he1ias/Holographic-Clock-Display/BOM.csv

Item | Qty | Supplier | Cost/item | Total Cost | link
XIAO RP2040 ESP32 | 1 | seeedstudio | $3.90 | $3.90 | https://www.seeedstudio.com/XIAO-RP2040-v1-0-p-5026.html
Display | 4 | LCSC | $2.22 | $8.88 | https://www.lcsc.com/product-detail/C7471924.html
Button | 10 | LCSC | $0.06 | $0.60 | https://www.lcsc.com/product-detail/C49393619.html
Thumbwheel Potentiometer | 1 | LCSC | $1.08 | $1.08 | https://www.lcsc.com/product-detail/C470643.html
Male pin headers | 5 | LCSC | $0.16 | $0.80 | https://www.lcsc.com/product-detail/C2337.html
JLCPCB | 1 | JLC | $4.00 | $4.00 | https://jlcpcb.com/
JLC3DP | 1 | JLC | $6.50 | $6.50 | https://www.jlc3dp.com
Reflective material (eg. acrylic sheet) (already owned) | 1 | Amazon | $0.01 | $0.01 | https://www.amazon.com.au/Pack-Clear-Acrylic-Sheets-Transparent/dp/B0H6PXC3K6
M2 Screws (already owned) | 4 | AliExpress | $0.01 | $0.04 | https://www.aliexpress.com/item/4000056753202.html
Estimated total shipping | 1 |  |  | $13.00
