he1ias/Holographic-Clock-Display/3D Outputs/Casing STEP Outputs/Hologram (Fixed) - Walls.step

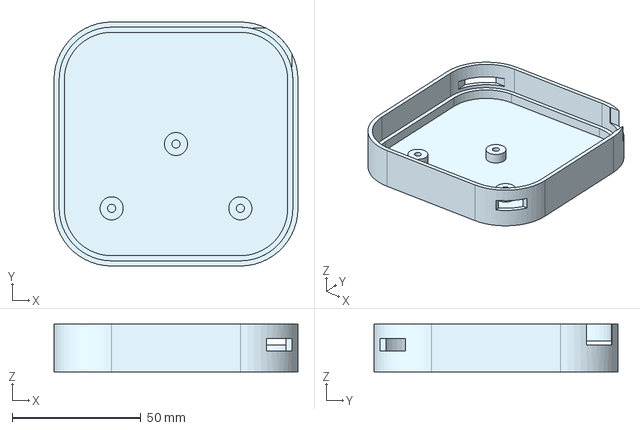
[picture p6: CAD file, 2026-10-31]
3D Outputs/Casing STEP Outputs/Hologram (Fixed) - Walls.step
94.8 x 94.8 x 18.5 mm
