he1ias/Holographic-Clock-Display/3D Outputs/Hologram_PCB.step

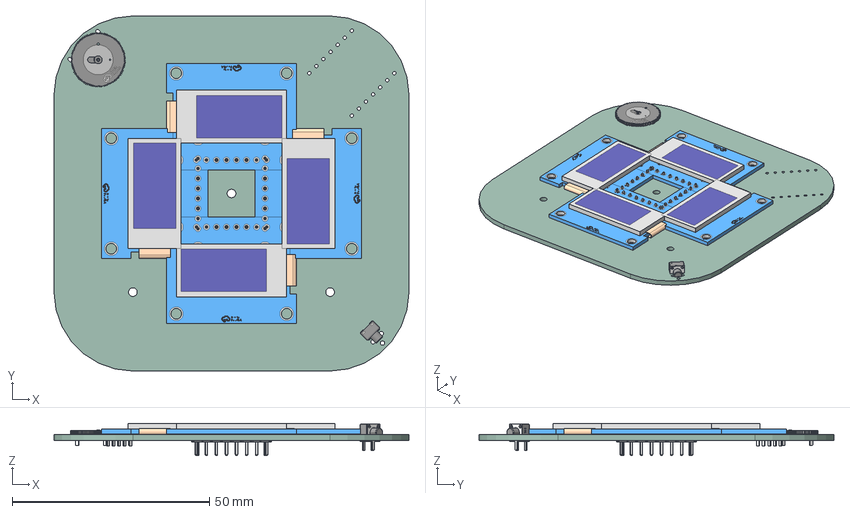
[picture p7: CAD file, 2026-10-31]
3D Outputs/Hologram_PCB.step
90.0 x 90.0 x 8.20 mm
SW-TH_3P-L4.5-W5.0-P3.00-LS1.9
LCD-TH_HS96S01A x 4
RES-TH_RK10J12E0A0A
Hologram_PCB
