he1ias/Holographic-Clock-Display/3D Outputs/Casing STEP Outputs/Hologram (Fixed) - Roof.step

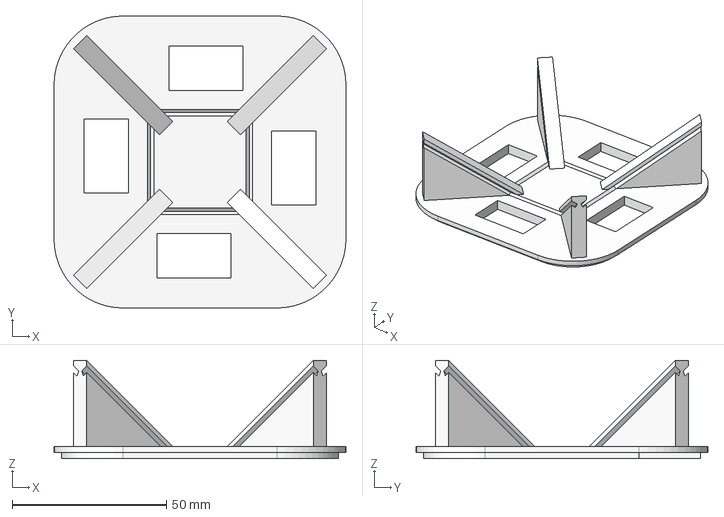
[picture p8: CAD file, 2026-10-31]
3D Outputs/Casing STEP Outputs/Hologram (Fixed) - Roof.step
94.8 x 94.8 x 31.9 mm
