he1ias/Holographic-Clock-Display/(list of files, cad)

Other CAD files:
3D Outputs/Casing STL Outputs/Hologram (Fixed) - Roof.stl
3D Outputs/Casing STL Outputs/Hologram (Fixed) - Walls.stl
