he1ias/Holographic-Clock-Display/KiCad Files/Hologram.kicad_pcb

## KiCad design KiCad Files/Hologram.kicad_pcb (2026-10-31)

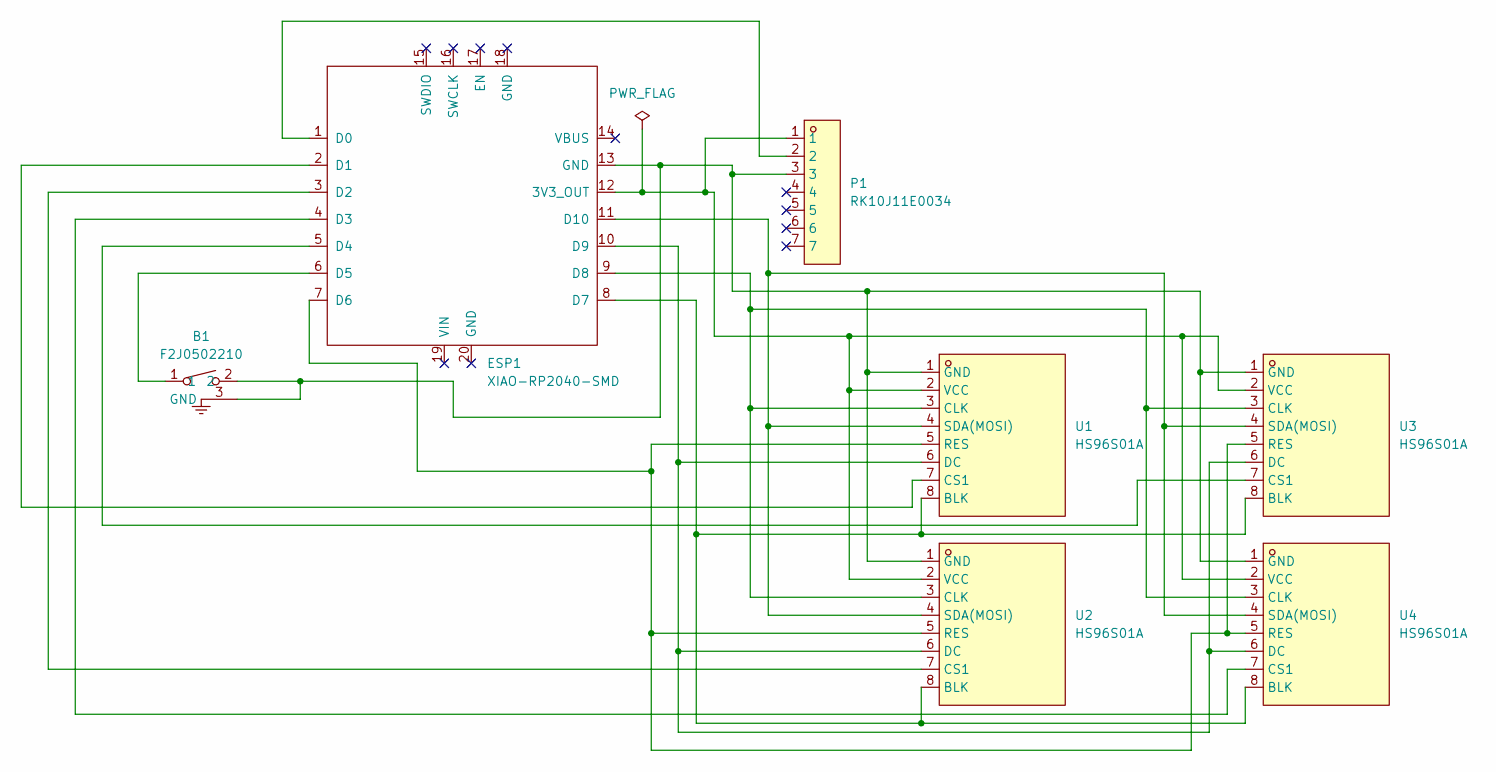
[picture p9: schematic Hologram.kicad_sch]

Parts:
B1: F2J0502210; SW-TH_3P-L4.5-W5.0-P3.00-LS1.9; MPN F2J0502210; LCSC Part C49393619
ESP1: XIAO-RP2040-SMD; XIAO-RP2040-DIP
P1: RK10J11E0034; RES-TH_RK10J12E0A0A; MPN RK10J11E0034; LCSC Part C470643
U1, U2, U3, U4: HS96S01A; LCD-TH_HS96S01A; MPN HS96S01A; LCSC Part C7471924

Connections:
unnamed: B1.2, B1.3 (GND), ESP1.13 (GND), P1.3, U1.1 (GND), U2.1 (GND), U3.1 (GND), U4.1 (GND)
unnamed: ESP1.12 (3V3_OUT), P1.1, U1.2 (VCC), U2.2 (VCC), U3.2 (VCC), U4.2 (VCC)
unnamed: ESP1.1 (D0), P1.2
unnamed: ESP1.2 (D1), U1.7 (CS1)
unnamed: ESP1.3 (D2), U2.7 (CS1)
unnamed: ESP1.4 (D3), U4.7 (CS1)
unnamed: ESP1.5 (D4), U3.7 (CS1)
unnamed: B1.1, ESP1.6 (D5)
unnamed: ESP1.7 (D6), U1.5 (RES), U2.5 (RES), U3.5 (RES), U4.5 (RES)
unnamed: ESP1.8 (D7), U1.8 (BLK), U2.8 (BLK), U3.8 (BLK), U4.8 (BLK)
unnamed: ESP1.9 (D8), U1.3 (CLK), U2.3 (CLK), U3.3 (CLK), U4.3 (CLK)
unnamed: ESP1.10 (D9), U1.6 (DC), U2.6 (DC), U3.6 (DC), U4.6 (DC)
unnamed: ESP1.11 (D10), U1.4 (SDA(MOSI)), U2.4 (SDA(MOSI)), U3.4 (SDA(MOSI)), U4.4 (SDA(MOSI))

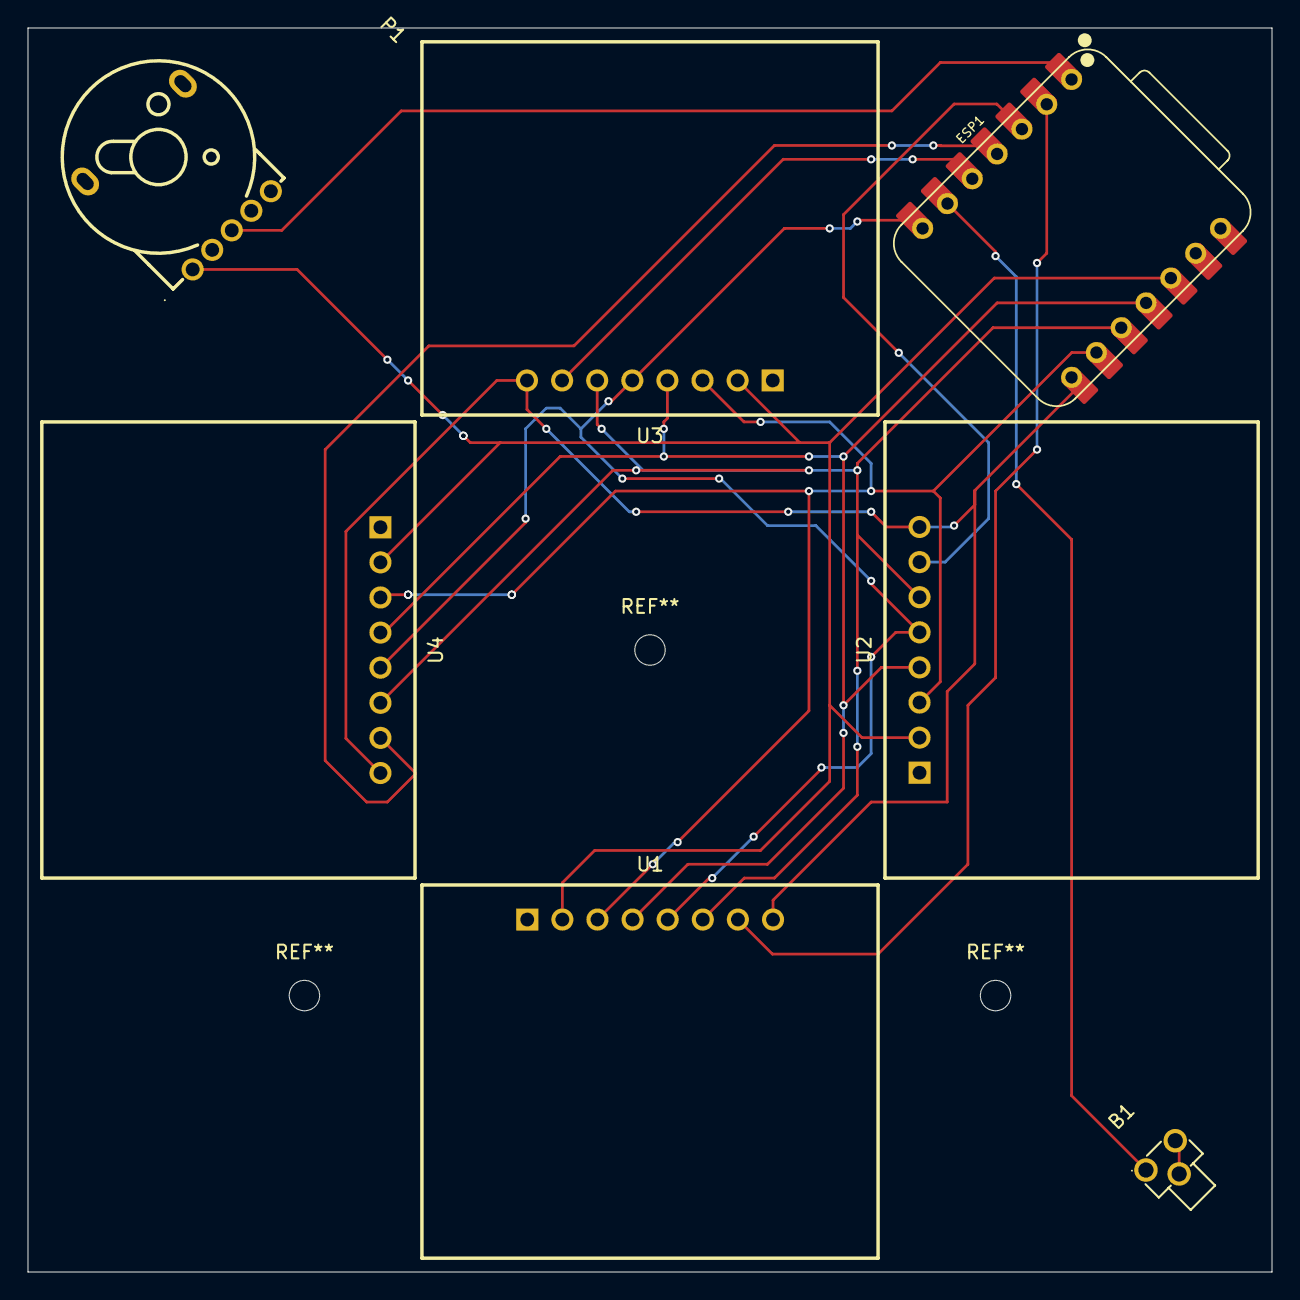
[picture p10: board Hologram.kicad_pcb from above]

Board: 2 copper layers, 90.0 x 90.0 mm, 7 parts (0 on the bottom side), 13 nets.
