he1ias/Holographic-Clock-Display/JOURNAL.md

# Holographic Clock Display: devlog

<!-- Generated by Half Life from project fidw1opzvqhmhvbq130ezi37. Edits here are overwritten on the next sync. -->
<!-- Generated: 2026-11-01T07:03:41.319Z -->

> [!NOTE]
> This devlog is mirrored from [Half Life](https://halflife.hackclub.com) ([open the project](https://halflife.hackclub.com/projects/fidw1opzvqhmhvbq130ezi37)). Editing it here will not change the platform's copy, and the next sync overwrites this file.

> A Holographic Clock Display for your bedside table, powered by the ESP32. Using the Pepper's Ghost visual effect, this display appears to 'float' in mid-air.  Comes with a wide range of pre-programmed clock-faces, visual effects, and relaxing animations. Works best when used in a dark room. Onshape URL: https://cad.onshape.com/documents/4a07292fcf3ec5a261f2cd78/w/7a4fcc3ff990e21e98229a03/e/6ea8dd64a432b46748776d14

| Week | Tier | Hours logged | Entries |
| --- | --- | --- | --- |
| Week 4 | Tier 1 | 19h | 4 |

## Contents

1. [2026-10-26: ## W4: Holographic Clock Display](#2026-10-26-w4-holographic-clock-display)
2. [2026-10-29: ## W4: Holographic Display](#2026-10-29-w4-holographic-display)
3. [2026-10-31: ## W4: Holographic Clock Display](#2026-10-31-w4-holographic-clock-display)
4. [2026-11-01: ## W4: Holographic Display](#2026-11-01-w4-holographic-display)

## Design

### 2026-10-26: ## W4: Holographic Clock Display

**3h**

## W4: Holographic Clock Display
### The prototype

I went with a much simpler (hopefully!) design this week because of exams!

This session was spent building prototypes for my holographic display.

Pepper's Ghost visual effects are created by securing a thin piece of transparent material at a 45° angle on top of a screen. This allows a viewer to see what is displayed on the screen without seeing the surface itself.

There are two ways I could have implemented this in my design, and I wanted to sus out each option:

* Using an inverted square pyramid, with a seperate image on each face. This creates a 3D-effect
* Using a single tilted piece of glass. This better utilises the whole surface of the underlying display

### The inverted square pyramid prototype

I started by scoring a large piece of acrylic into small, triangle shaped pieces (this took wayyyy too long!!!):

IMG_8470 Large

IMG_8471 Large

I then assembled the pyramid:

IMG_8476 Large

I then used a jellyfish image to test my prototype (sorry about the blurry image).

IMG_8474 Large

The advantage of this is that each edge of the pyramid can have its own image, giving a 3D effect. However, the need for 4 seperate displays, or 1 much larger display, could complicate the PCB design.

### The tilted glass prototype

This prototype was much simpler. After scoring the acrylic sheet into an 8x8cm square, I arrived at the following:

IMG_8478 Large

The jellyfish is still visible even as the screen gets much further away, as long as it's directly above:

IMG_8479 Large

The advantage of this is it makes PCB and casing design much simpler, while only allowing one viewing angle.

### The verdict

I decided to go with the pyramid, as it will allow me to better create 3D effects and feel more polished as a project.

Next up is selecting parts, then schematic and PCB design, casing, and firmware!

Thanks for reading :)

### 2026-10-29: ## W4: Holographic Display

**6h**

## W4: Holographic Display
### Selecting parts, designing the schematic, and assembling the casing

Going with the pyramid display idea, the key contraint was that I would need 4 small displays that can be powered at the same time by an ESP-32. I searched through components on LCSC, as this would save on shipping since you can purchase it at the same time as JLCPCB and JLC3DP orders.

As well as the displays, I searched for buttons, for effect selection, and a thumbwheel potentiometer for brightness control. I also needed to purchase male headers to secure all the pieces together. For the microcontroller, I decided to use the XIAO ESP-32 due to its small footprint, however as this was not on LCSC the cost of the controller plus the shipping ended up being around ~$10. I arrived at the following:

```
W4:
  SEED Studio
    Microcontroller:
      https://wiki.seeedstudio.com/XIAO-RP2040/ (~$10)
      (footprints / schematics: https://wiki.seeedstudio.com/XIAO-RP2040/#resources)

  LCSC:
    Displays:
      4 * https://www.lcsc.com/product-detail/C7471924.html ($8.88)

    Buttons (for image selection):
      https://www.lcsc.com/product-detail/C49393619.html

    Potentiometer (for brightness control):
      https://www.lcsc.com/product-detail/C470643.html

    Male Headers (for connecting everything together):
      https://www.lcsc.com/product-detail/C2337.html

    (these combined are around ~$3)

  JLC:
    PCB: ~$4
    Casing: ~$2

  Plastic / glass pyramid / panel (any reflective plastic you have lying around)

  shipping: ~$5

  total: just under ~$30
```

### The schematic

I first sourced the footprints and symbols of my parts online:

IMG_8487 Large

I then connected them all up:

IMG_8489 Large

Note all the display share most SPI data connections, including CLK, SDA, BLK etc. The only difference is each display has its own CS (chip select) line, allowing me to drive all of them at once, or alternatively select each one seperately and display different images in each.

I then assembled the layout of my PCB:

IMG_8490 Large

...and exported the 3D model:

IMG_8491 Large

### The casing

Using Onshape, I imported the 3D model:



Created the container for the PCB:



...and added holes for the USB-C port and inputs.

Journal image

I arrived at the following:



### What's next

Next up is routing the PCB, adding drill holes to secure it to the casing, adding the holder for the reflective material, and finally writing the firmware.

Thanks for reading!

### 2026-10-31: ## W4: Holographic Clock Display

**8h**

## W4: Holographic Clock Display
### Completing the Schematic, PCB & Casing

A lot of work was done this session completing the CAD part of this week's project.

### PCB & Schematic

I first had to finalise the schematic. I found that some wires were incorrectly connected upon testing in the PCB editor, and so I had to fix these. I then finalised the layout of my PCB:

IMG_8490 Large

I then began connecting the ratlines. This took me quite a while, and I found my wiring to be quite messy and complicated, as all 4 screens had to share display & power lines. It looked a bit like this:

IMG_8508 Large

I then added a copper fill connected to the GND net:

IMG_8510 Large

The finalised PCB ended up looking like the following:

IMG_8512 Large

After passing DRC, I exported Gerber & Drill files in both compressed and uncompressed format, as well as STEP & STL 3D outputs. These, as well as the KiCad project files, were uploaded to my GitHub repository.

### 3D-Printed Casing

I began by adding a ledge in the casing for the PCB to lean on, holding it at the correct height 4.4mm above the base:



I then began work on the roof of the case. The roof as the same size as the base of the case, with a bottom lip the same size as the PCB to prevent the roof from slipping out. A small hole was indented in this lip to make room for the USB-C cable. Using the screen's datasheet, as well as some calculations, I made some holes in the roof for the screens.



I then calculated the height / width of the pillars that will hold the transparent pieces. They will be 3cm in width at the top of the roof, and just under 9cm in width at the top of the structure. In Onshape I did alter my computed values a bit, however, to get the right padding and spacing.

IMG_8513 Large

Rotating the transparent pieces:





With these, I built 4 triangular prisms and indented the holes the trapeziums make:





Finally, I added some screwholes to mount my PCB into the casing. Note that the roof doesn't get mounted on, however as the display won't be moved very often this shouldn't be a problem.



The final product looked like this:



Putting the STEP files into JLC3DP, I found that the final cost would be a few more dollars than I originally anticipated, so I updated the BOM accordingly.



All that's left to do is write the README, and firmware for the ESP32!

Thanks for reading :)

### 2026-11-01: ## W4: Holographic Display

**2h**

## W4: Holographic Display
### Wrapping it up

This session was spent writing the shell of the firmware, and finalising the GitHub repository.

I first wrote some code in Python for my microcontroller. As I don't have the ESP32 or the displays yet, I wasn't able to write any I/O code that would actually display any images, however I did write the shell in that it will be much easier for me to start writing code directly for the displays in build week, as the display & update loops, as well as initialisation, is already set up.

In build week, all my time will therefore be spent on creating cool effects for the displays. The code looked a bit like the following:



I then wrote my `README.md` file and made sure everything I needed was in my repository. It ended up looking like the following:



That wraps up this weeks project!

Thanks for reading :)
