he1ias/Holographic-Clock-Display/(commit log)

2026-10-27 Sync Holographic Clock Display from Half Life
    [BOM.csv]
2026-10-31 KiCad Exports
    [Hologram-B_Cu.gbr, Hologram-B_Mask.gbr, Hologram-B_Paste.gbr, Hologram-B_Silkscreen.gbr, Hologram-Edge_Cuts.gbr, Hologram-F_Cu.gbr, Hologram-F_Mask.gbr, Hologram-F_Paste.gbr]
2026-10-31 Added 3D Outputs
    [Hologram (Fixed) - Roof.step, Hologram (Fixed) - Roof.stl, Hologram (Fixed) - Walls.step, Hologram (Fixed) - Walls.stl]
